0xCodExpert/MotorJig/README.md

# MotorJig
- 모터 및 ST MCU 제어 테스트를 위한 프로젝트 시작
- 모 든 프로젝트는 github 관리를 원칙적으로 한다.
- EziStep  하나를 짜봄으로써 통신에 대해 이해를 넓힌다.

# V0.0 (210315)
- PC to MCU EziStep Protocol 통신 
- PC와 다른 라인으로 MCU to Driver 통신 라인 구현
- 1차 동작 가능 파일 구현
