0xCodExpert/MotorJig/PL/MOTOR JIG_V0.3_201222.xlsx

Sheet: 표지
전자부 Part List
 |  |  | ART_Motor Jig
 |  |  |  |  |  | 2020-12-22 (V0.3)
 | 담당 부서 |  |  |  |  |  | 합의 부서
 | 구분 | 이름 |  | 서명 | 일자 |  | 구분 | 이름 | 서명 | 일자
 | 담당 | 박 성 환 |  |  | 2020-12-22 |  | 담당
 | 검토 | 강 유 정 |  |  | 2020-12-22 |  | 검토
 | 승인 | 윤 경 훈 |  |  | 2020-12-22 |  | 승인
RQP-701-6r2
전자부 Part List Vieworks co.,Ltd.

Sheet: HISTORY
Version History
Version | Date | 변경 부분 | ASS'Y Code | 변경 내용 | 변경 전 | 변경 후 | 참조 문서 | 비고
V0.0 | 2020-12-07 | 최초작성
V0.1 | 2020-12-18 | 정식PL 버전
V0.2 | 2020-12-21 | SMT 과정 오류 발견 수정
V0.3 | 2020-12-22 | SMT 과정 오류 발견 수정

Sheet: ART_MotorJig
MODEL : VISQUE InVivo ART , BOARD NAME : MOTOR_JIG , 보드명 Main PCB Ass'y Code : 1631-3007-D01 .
No. | Part Number | Description | Specification | Manufacturer | Q'ty | Reference | 비고 | 회사 | 개별
1 | 1631-3307-D01 | 140mm x 100mm, FR-4, 2layer, 1.6T, 금도금, 무광 | ART MOTOR JIG PCB | EOS | 1
2 | 9060-0039-10AG | IND-BEAD,120Ω,SMD,1608 | ACMS160808A121 2A | Maxecho | 2 | B1,B2 |  | o
3 |  | CON-HEADER,VERTICAL,2.54,DIP,5P | HEADER2.54MM-5P | GIN LING | 1 | CON1 |  |  | o
4 |  | CON-HEADER,VERTICAL,2.54,DIP,4P | HEADER2.54MM-4P | GIN LING | 1 | CON2 |  |  | o
5 |  | CON-HEADER,RA,5.08,DIP,3P,300V/12A | TB39R(3P) | DINKLE | 4 | CON3,CON5,CON6,CON7 |  |  | o
6 | 9070-0357-01A | CON-USB A type,RECEPTACLE,R/A | 67643-3911 | Molex | 1 | CON4 |  | o
7 |  | CON-HEADER,RA,3.81,DIP,16P | ECH381R(16P) | DINKLE | 1 | CON8 |  |  | o
8 |  | IC-Voltage Translator,8bit,Bidirectional | SN74GTL2003 | Ti | 2 | CON9,CON11 |  |  | o
9 |  | CON-HEADER,RA,3.81,DIP,10P | ECH381R(10P) | DINKLE | 1 | CON12 |  |  | o
10 |  | CON-HEADERBOX,VERTICAL,2.54,DIP,20X2P | HEADER-20X2(2.54MM)_BOX | GIN LING | 1 | CON14 |  |  | o
11 | 9070-0201-00AG | CON-HEADER,VERTICAL,2.5,DIP,2P | 5267-02A | Molex | 2 | CON15,CON16 |  |  | o
12 |  | CON-DC JACK,30V/0.5A,E-type | DC-005 | BSUN | 1 | CON17 |  |  | o
13 |  | CON-HEADER,RA,5.08,DIP,2P,300V/12A | TB39R(2P) | DINKLE | 3 | CON10,CON13,CON18 |  |  | o
14 | 9030-0201-01A | CAP-MLCC,10nF,50V,1608,X7R,±10%,ESD25kV | C0603C103K5REC | KEMET | 1 | C1 |  | o
15 | 9030-0178-01A | CAP-MLCC,22uF,6.3V,2012,X5R,±15% | GRM21BR60J226ME39L | Murata | 1 | C2 |  | o
16 | 9030-0180-11A | CAP-MLCC,10uF,50V,3225,Y5V,-20/+80% | GRM32DF51H106ZA01L | Murata | 5 | C3,C29,C32,C34,C36 |  | o
17 | 9030-0109-00AG | CAP-MLCC,0.1uF,50V,1608,X7R,±10% | CL10B104KB8NNNC | Samsung | 19 | C4,C6,C9,C10,C12, C15,C17,C18,C20,C25 C22,C23,C27,C30,C31, C33,C35,C37,C38 |  | o
18 | 9030-0131-00AG | CAP-MLCC,10uF,50V,3216,X5R,±10% | CL31A106KBHNNNE | Samsung | 1 | C5 |  | o
19 | 9030-0108-00AG | CAP-MLCC,8pF,50V,1608,COG,±0.5pF | CL10C080DBNC | Samsung | 2 | C7,C8 |  | o
20 | 9030-0159-01A | CAP-MLCC,18pF,50V,1608,C0G,±5% | CL10C180JB8NNNC | Samsung | 2 | C11,C14 |  | o
21 | 9030-0119-00AG | CAP-MLCC,2.2uF,25V,1608,X5R,±10% | CL10A225KA5LNN | Samsung | 2 | C13,C19 |  | o
22 | 9030-0264-01A | CAP-MLCC,10uF,25V,1608,X5R,±20% | CL10A106MA8NRNC | Samsung | 3 | C21,C24,C16 |  | o
23 | 9030-0101-00AG | CAP-MLCC,2200pF,50V,1608,X7R,±10% | CL10B222KBNC | Samsung | 1 | C26 |  | o
24 | 9030-0129-00AG | CAP-MLCC,1uF,50V,1608,X5R,±10% | CL10A105KB8NNN | Samsung | 1 | C28 |  | o
25 | 9040-0084-01A | DIO-TVS DIODES,36V,BIDIRECTIONAL,SOD-323 | PSD36C | Protek | 2 | D1,D6 |  |  | o
26 | 9040-0092-00A | DIO-SCHOTTKY,8A,40V,DO214AB | SK84L | Micro | 1 | D2 |  |  | o
27 |  | DIO-ZENER,5.1V,3W,SMD | 1SMB5918BT3G | ON SEMICONDUCTOR | 1 | D3 |  |  | o
28 | 9040-0087-01A | DIO-SCHOTTKY,8A,100V,DO214AB | SK810L | Micro | 2 | D4,D5 |  |  | o
29 |  | DIO-SCHOTTKY,1.5A,24V,SOD-323 | SD103AWS | Guangdong Hottech | 1 | D8 |  |  | o
30 |  | CAP-ELEC,KMG,100uF,35V,CAPE(6.3)P2.5 | KMG/100uF/35V | SamYoung Electronics | 5 | EC1,EC2,EC3,EC6,EC7 |  |  | o
31 | 9030-0181-01A | CAP-MLCC,47uF,16V,3216,X5R,±20% | NC | TDK | 1 | EC4 |  |  | o
32 | 9030-0181-01A | CAP-MLCC,47uF,16V,3216,X5R,±20% | C3216X5R1C476M | TDK | 2 | EC5,EC8 |  | o
33 | 9040-0058-00AG | DIO-TVS DIODES,3V,BIDIRECTIONAL,SOD-323 | GBLC03 | Protek | 5 | IZ1,IZ2,IZ3,IZ4,IZ5 |  |  | o
34 |  | DIO-LED,SMD,1608 | LED-RED | HSUKWANG | 1 | LED1 |  |  | o
35 |  | DIO-LED,3MM,2COLOR | BL-BST201 | Bright Power Semiconductor | 1 | LED2
36 | 9060-0026-00AG | IND-COIL,47uH,2.4A,SMD CORE,±20%,10.1X10.1X4.5 | SHP1045P-F470A | Tokyo-Coil | 1 | L1 |  |  | o
37 |  | CON-RJ45,RA,5e,Modular Jack,8P | 440500001 | Molex | 2 | P1,P2
38 | 9010-0309-00AG | IC-Single P-Channel Mosfet,SO-8 | FDS6675BZ | Fairchild | 2 | Q2,Q4 |  | o
39 | 9050-0005-00AG | TR-BJT,NPN,100mA,Built-in Resistor,SMT3 | DTC143EKA | Rohm | 2 | Q3,Q5 |  | o
40 | 9020-0049-00AG | RES-SMD1608,3.6KΩ,F,1/10W | MCR03EZPFX3601 | Rohm | 1 | R1 |  | o
41 | 9020-0298-01A | RES-SMD1608,11KΩ,F,1/10W | MCR03EZPFX1102 | Rohm | 1 | R2 |  | o
42 | 9020-0067-00AG | RES-SMD1608,470Ω,F,1/10W | MCR03EZPFX4700 | Rohm | 1 | R3 |  | o
43 | 9020-0009-00AG | RES-SMD1608,10KΩ,F,1/10W | MCR03EZPFX1002 | Rohm | 2 | R4,R6 |  | o
44 | 9020-0007-00AG | RES-SMD1608,100Ω,F,1/10W | MCR03EZPFX1000 | Rohm | 1 | R7 |  | o
45 | 9020-0026-00AG | RES-SMD1608,1MΩ,F,1/10W | MCR03EZPFX1004 | Rohm | 1 | R8 |  | o
46 | 9020-0114-00AG | RES-SMD1608,120Ω,F,1/10W | MCR03EZPFX1200 | Rohm | 3 | R9,R11,R12 |  | o
47 | 9020-0064-00AG | RES-SMD1608,4.7KΩ,F,1/10W | MCR03EZPFX4701 | Rohm | 2 | R10,R13 |  | o
48 | 9020-0053-00AG | RES-SMD1608,330Ω,F,1/10W | MCR03EZPFX3300 | Rohm | 2 | R14,R15 |  | o
49 | 9020-0026-00AG | RES-SMD1608,1MΩ,F,1/10W | MCR03EZPFX1004 | Rohm | 1 | R16 |  | o
50 |  |  | NC |  | 1 | R17 |  | o
51 | 9020-0064-00AG | RES-SMD1608,4.7KΩ,F,1/10W | MCR03EZPFX4701 | Rohm | 3 | R18,R60,R61 |  | o
52 | 9020-0023-00AG | RES-SMD1608,1KΩ,F,1/10W | MCR03EZPFX1001 | Rohm | 2 | R19,R21 |  | o
53 |  |  | NC |  | 1 | R20 |  | o
54 | 9020-0188-00AG | RES-SMD1608,200KΩ,F,1/10W | MCR03EZPFX2003 | Rohm | 2 | R22,R41 |  | o
55 | 9020-0498-01A | RES-SMD1608,499Ω,F,1/10W | RC1608F4990CS | Samsung | 16 | R23,R24,R25,R35,R36, R37,R38,R39,R51,R52, R53,R54,R55,R56,R57,R58 |  | o
56 | 9020-0052-00AG | RES-SMD1608,300Ω,F,1/10W | MCR03EZPFX3000 | Rohm | 16 | R26,R27,R28,R29,R30, R31,R33,R34,R42,R43, R44,R45,R46,R47,R49, R50 |  | o
57 | 9020-0009-00AG | RES-SMD1608,10KΩ,F,1/10W | MCR03EZPFX1002 | Rohm | 6 | R40,R59,R66,R67,R68, R69 |  | o
58 | 9020-0189-00AG | RES-SMD1608,20Ω,F,1/10W | MCR03EZPFX20R0 | Rohm | 2 | R62,R63 |  | o
59 | 9020-0289-01A | RES-SMD2012,0Ω,J,1/8W | NC | Rohm | 1 | R64 |  | o
60 | 9020-0289-01A | RES-SMD2012,0Ω,J,1/8W | MCR10EZPJ000 | Rohm | 1 | R65 |  | o
61 |  | SW-TACT,12V,VERTICAL,SMD | TS-1187SMD | 씨티전자 | 1 | SW1 |  |  | o
62 |  | IC-Regulator,Switching,Step-Down,45V,3A | LM2596S-ADJ | UMW | 1 | U1 |  |  | o
63 | 9010-0745-01A | IC-Regulator, LDO, 3.3V, 0.8A, SOT223 | LM1117IMPX-3.3 | Ti | 1 | U2 |  |  | o
64 |  | IC-MCU,M7,Flash-128KB, RAM-1MB,82P | STM32H750VBT6 | ST | 1 | U3
65 | 9010-1092-01A | IC-RS485/RS422 Transceiver,8-SOIC | SP3485EN | MaxLinear | 1 | U4 |  |  | o
66 | 9010-0746-01A | IC-USB to UART, 28-SSOP | FT232RL | FTDI | 1 | U5
67 | 9010-0753-01A | IC-ESD PROTECTION,SON6 | TPD4S012DRYR | Ti | 1 | U6 |  | o
68 | 9010-0711-01A | IC-RS485/RS422 Transceiver,8-SOIC | MAX485CSA | Maxim | 1 | U7 |  |  | o
69 |  | OSC-CRYSTAL,32.7680kHz,7PF,SMD | CM315D32768DZYT-7pF | Citizen | 1 | Y1 |  |  | o
70 | 9080-0035-01A | OSC-CRYSTAL,24MHz,SMD,3.2x2.5mm,18pF,±30ppm | CE300X24003TKO | Exa | 1 | Y2 |  | o
 |  |  |  |  | 164
