0xCodExpert/MotorJig/PL/통합 문서1.xlsx

Sheet: ART_MotorJig
Item | Quantity | Reference | Part | PCB Footprint
1 | 2 | B1,B2 | ACMS160808A121 | L1608
2 | 1 | CON1 | HEADER2.54MM-5P | HEADER2.54MM-5P
3 | 1 | CON2 | HEADER2.54MM-4P | HEADER2.54MM-4P
4 | 4 | CON3,CON5,CON6,CON7 | TB39R(3P) | TB39R(3P)
5 | 1 | CON4 | 67643-3911 | USB_A/67643-3911
6 | 1 | CON8 | ECH381R(16P) | ECH381R(16P)
7 | 2 | CON9,CON11 | SN74GTL2003 | SN74GTL2003
8 | 1 | CON12 | ECH381R(8P) | ECH381R(8P)
9 | 1 | CON14 | HEADER-20X2(2.54MM)_BOX | HEADER-20X2(2.54MM)_BOX
10 | 2 | CON15,CON16 | 5267-02A | 5267-02A
11 | 1 | CON17 | DC-005 | EPX3333K
12 | 3 | CON10,CON13,CON18 | TB39R(2P) | TB39R(2P)
13 | 1 | C1 | 10nF/50V | C1608
14 | 1 | C2 | 22uF/6.3V/2012 | C2012
15 | 5 | C3,C29,C32,C34,C36 | 10uF/50V/3225 | C3225
16 | 19 | C4,C6,C9,C10,C12, C15,C17,C18,C20,C25 C22,C23,C27,C30,C31, C33,C35,C37,C38 | 0.1uF/50V | C1608
17 | 1 | C5 | 10uF/16V/3216 | C3216
18 | 2 | C7,C8 | 8pF | C1608
19 | 2 | C11,C14 | 18pF | C1608
20 | 2 | C13,C19 | 2.2uF | C1608
21 | 3 | C21,C24,C16 | 10uF/10V | C1608
22 | 1 | C26 | 2200pF | C1608
23 | 1 | C28 | 1uF | C1608
24 | 2 | D1,D6 | PSD36C | PSD36C
25 | 1 | D2 | SK84L | SK84L
26 | 1 | D3 | 1SMB5918BT3G | CASE403A
27 | 2 | D4,D5 | SK810L | SK810L
28 | 1 | D8 | SD103AWS | SD103AWS
29 | 5 | EC1,EC2,EC3,EC6,EC7 | 100uF/35V | KMG,100uF/35V
30 | 1 | EC4 | NC | EC-4.8X12-330F/16V
31 | 2 | EC5,EC8 | 100uF/6.3V | C3216
32 | 5 | IZ1,IZ2,IZ3,IZ4,IZ5 | GBLC03 | SOD-323
33 | 1 | LED1 | LED-RED | LED-1608
34 | 1 | LED2 | BL-BST201 | LED(2COL_3P)
35 | 1 | L1 | SHP1045P-F470A | SHP1045P-F470A
36 | 2 | P1,P2 | 440500001 | 440500001
37 | 2 | Q2,Q4 | FDS6675BZ | SO8(P1.27-W7.2)
38 | 2 | Q3,Q5 | DTC143EKA | SOT23-3P
39 | 1 | R1 | 3.6K | R1608
40 | 1 | R2 | 11K | R1608
41 | 1 | R3 | 470R | R1608
42 | 2 | R4,R6 | 10K | R1608
43 | 1 | R7 | 100R | R1608
44 | 1 | R8 | 1M | R1608
45 | 3 | R9,R11,R12 | 120R | R1608
46 | 2 | R10,R13 | 4.7K | R1608
47 | 2 | R14,R15 | 330 | R1608
48 | 1 | R16 | 1M | R1608
49 | 1 | R17 | NC | R1608
50 | 3 | R18,R60,R61 | 4.7K | R1608
51 | 2 | R19,R21 | 1K | R1608
52 | 1 | R20 | NC | R1608
53 | 2 | R22,R41 | 200K | R1608
54 | 16 | R23,R24,R25,R35,R36, R37,R38,R39,R51,R52, R53,R54,R55,R56,R57,R58 | 499 | R1608
55 | 18 | R26,R27,R28,R29,R30, R31,R32,R33,R34,R42, R43,R44,R45,R46,R47, R48,R49,R50 | 300 | R1608
56 | 2 | R40,R59 | 10K | R1608
57 | 2 | R62,R63 | 20 | R1608
58 | 1 | R64 | NC | R2012
59 | 1 | R65 | 0/2012 | R2012
60 | 1 | SW1 | TS-1187SMD | TS-1187SMD
61 | 1 | U1 | LM2596S-ADJ | TO263
62 | 1 | U2 | LM1117IMPX-3.3 | SOT223
63 | 1 | U3 | STM32H750VBT6 | LQFP100P_STM32_0.5_16X16_H1.6
64 | 1 | U4 | SP3485EN | SP485EN-SOIC8-1.27X5X6.2X1.8T
65 | 1 | U5 | FT232RL | FT232RL/SSOP28
66 | 1 | U6 | TPD4S012 | TPD4S012
67 | 1 | U7 | MAX485CSA | SO8(P1.27-W7.2)
68 | 1 | Y1 | CM315D32768DZYT-7pF | XTAL-CM315
69 | 1 | Y2 | SX-1/25MHz | SX-1/25MHz
 | 161

Sheet: Stage_Sub
Item | Quantity | Reference | Part | PCB Footprint
1 | 1 | SB45 | ACMS201209A121 | L2012
2 | 1 | SCON3 | 5267-06A | 5267-6P(P2.5)OK
3 | 1 | SCON8 | ECH381R(16P) | ECH381R(16P)
4 | 1 | SCON9 | SN74GTL2003 | SN74GTL2003
5 | 2 | SCON10,SCON48 | TB39R(2P) | TB39R(2P)
6 | 2 | SCON45,SCON46 | 5267-02A | 5267-2P(P2.5)OK
7 | 1 | SCON47 | 53047_1510 | 53047-1510(15P-1.25)
8 | 3 | SC1,SC2,SC3 | 22uF/35V | C3216
9 | 1 | SC3 | 10uF | C2012
10 | 2 | SC4,SC5 | 10uF/50V | C3216
11 | 3 | SC5,SC223,SC224 | 0.1uF | C1608
12 | 1 | SC6 | 10u/6.3V | C1608
13 | 4 | SC29,SC32,SC225,SC226 | 10u/50V | C2012
14 | 2 | SC30,SC31 | 0.1uF | C1608
15 | 1 | SD1 | STPS40L45CG | D2PAK/STPS40L45CG
17 | 2 | SQ2,SQ5 | FDS6675BZ | SO8(P1.27-W7.2)
18 | 2 | SQ3,SQ6 | DTC143EKA | SOT23-3P
19 | 1 | SR3 | 10 | R1608
20 | 1 | SR22 | 200K | R1608
21 | 6 | SR23,SR35,SR36,SR37,SR38, SR39 | 499 | R1608
22 | 6 | SR28,SR29,SR30,SR31,SR33, SR34 | 300 | R1608
23 | 2 | SR40,SR326 | 10K | R1608
24 | 2 | SR324,SR325 | 4.7K | R1608
25 | 1 | SR327 | 0/NC | R1608
26 | 1 | SR328 | 0/2012/NC | R2012
27 | 2 | SR329,SR330 | 20 | R1608
28 | 1 | SR331 | 0/2012 | R2012
29 | 1 | SU3 | LM1117IMPX-3.3 | SOT-223
30 | 2 | SZ1,SZ2 | PSD36C | SOD-323
 | 56
