0xCodExpert/MotorJig/Circuit/ART_MOTORJIG(201208).pdf

5

4

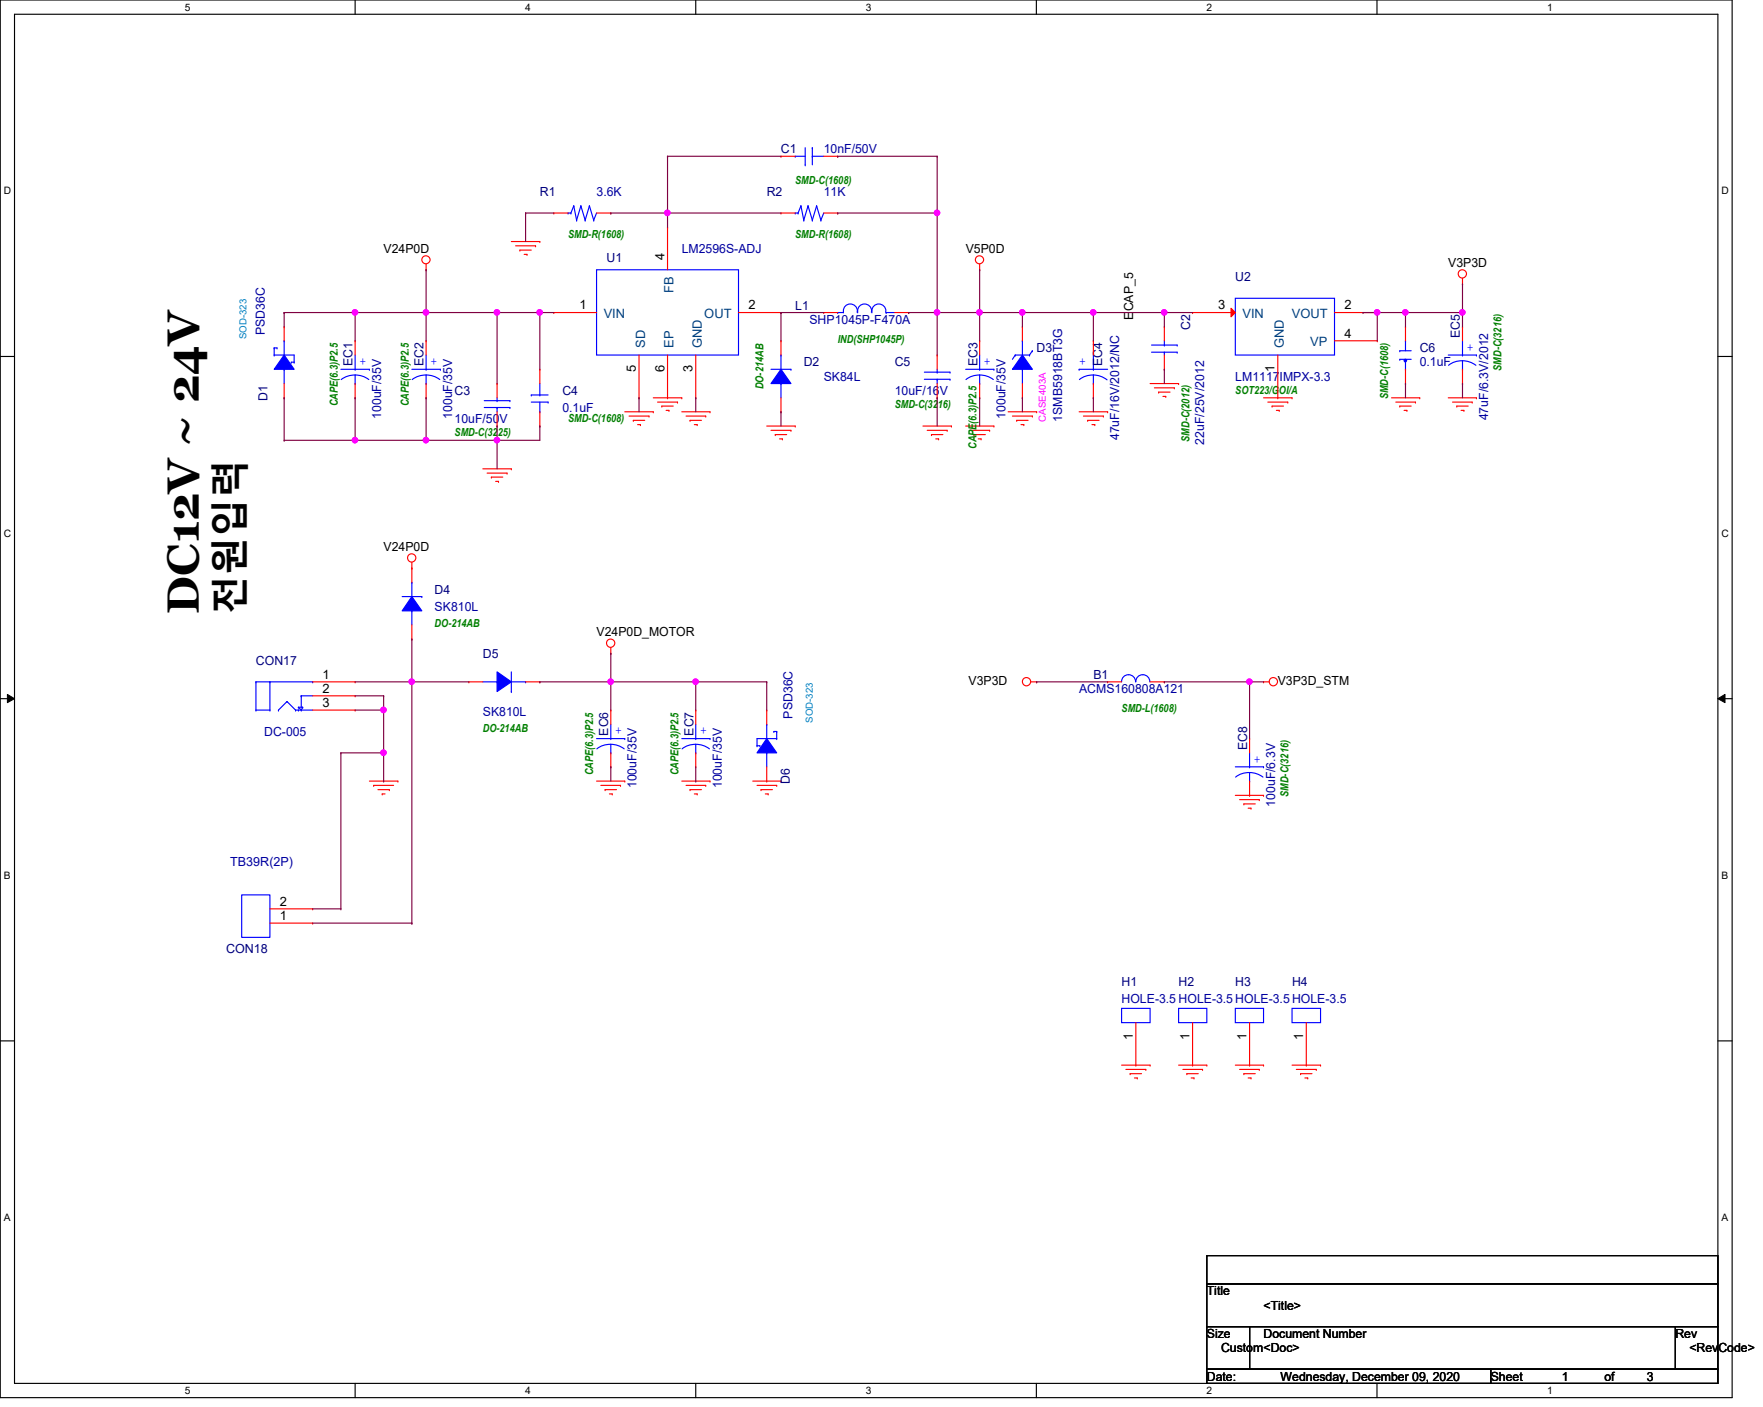
[picture p5: page 1]

# MCU RESET

# RTC XTAL

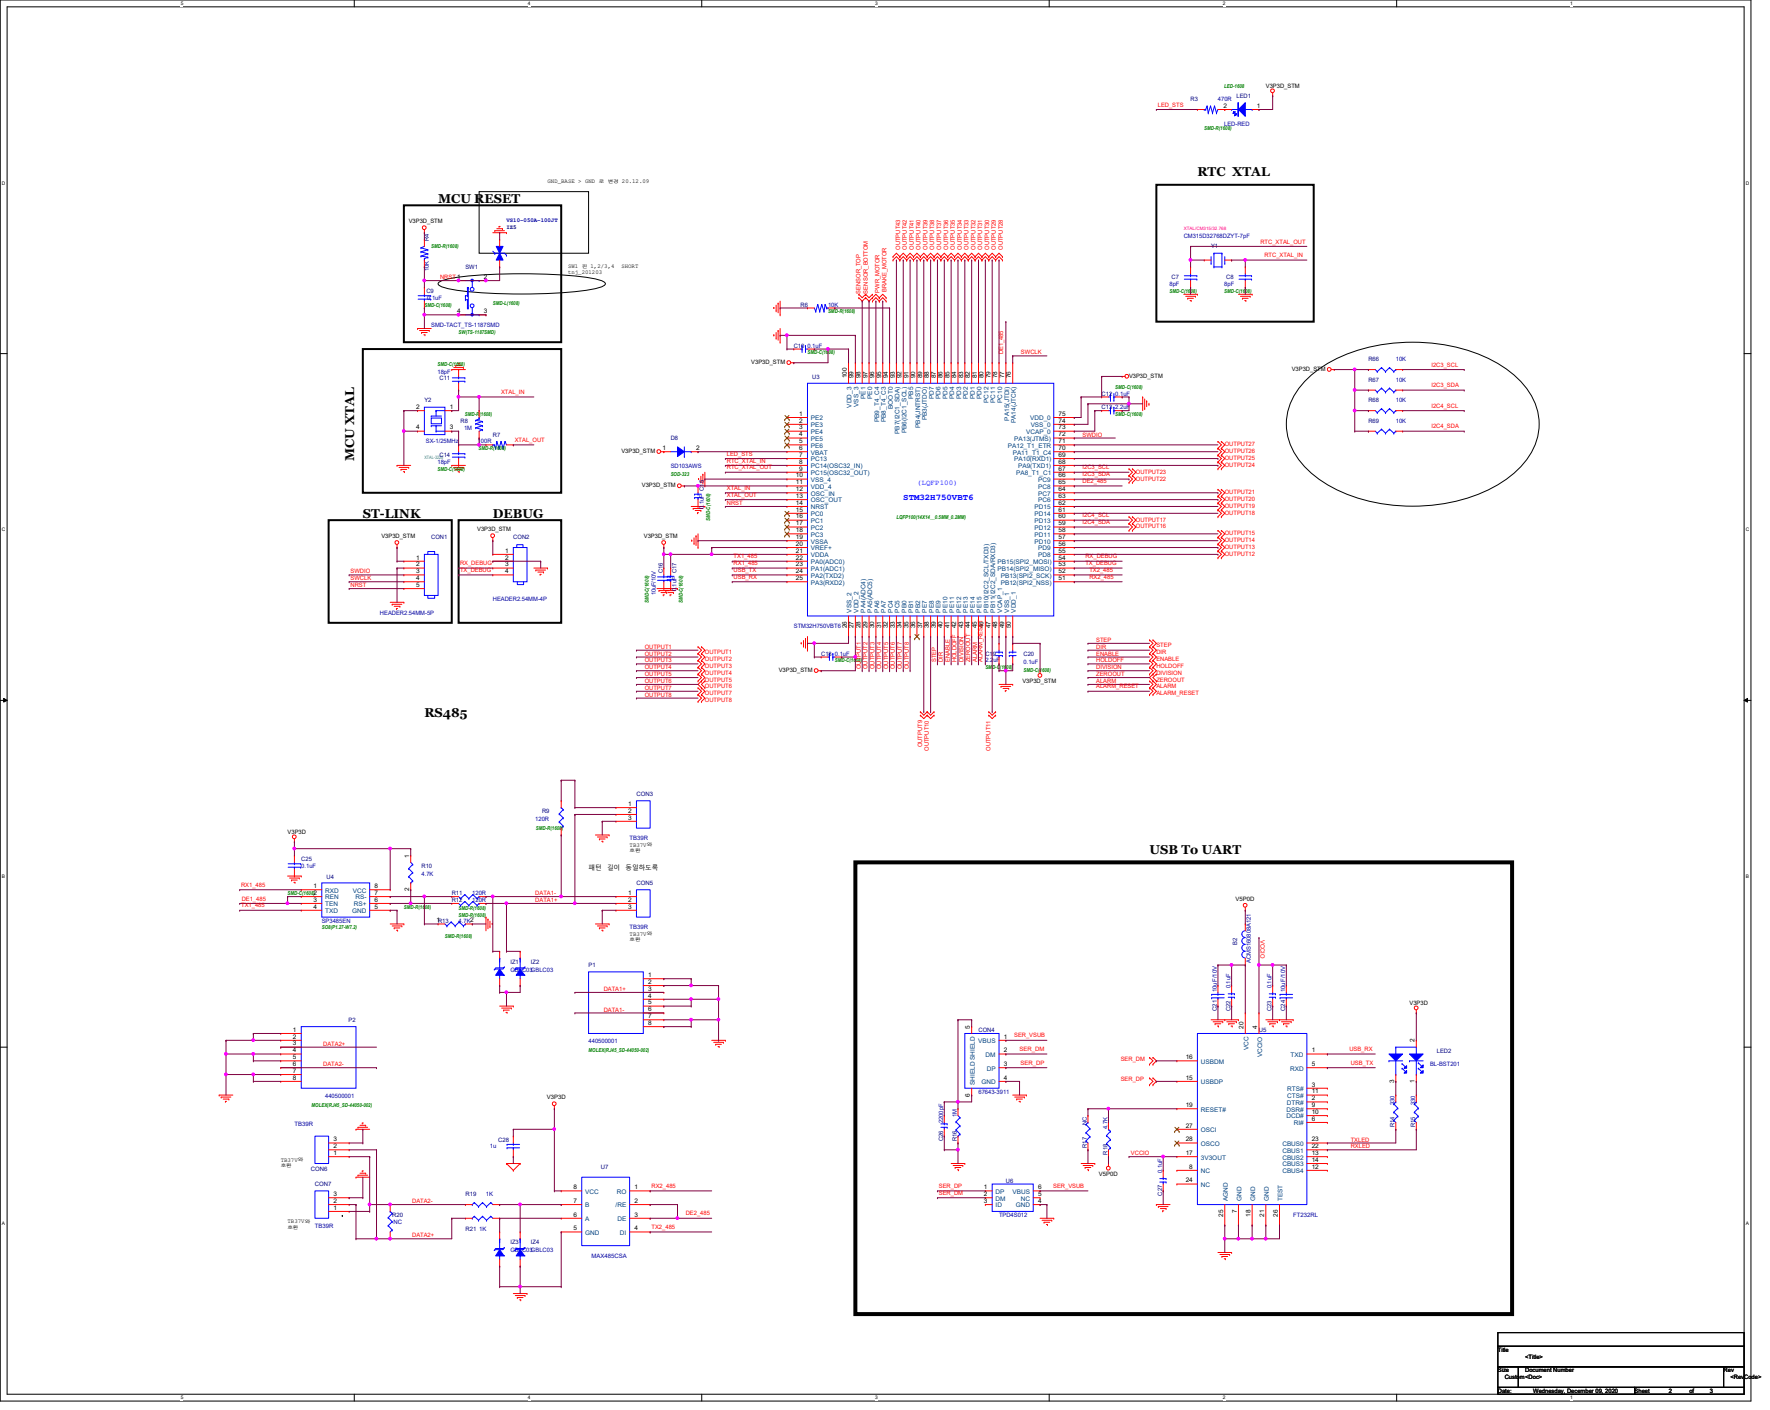
[picture p6: page 2]

D D

## R32/R48 부품 겹쳐서

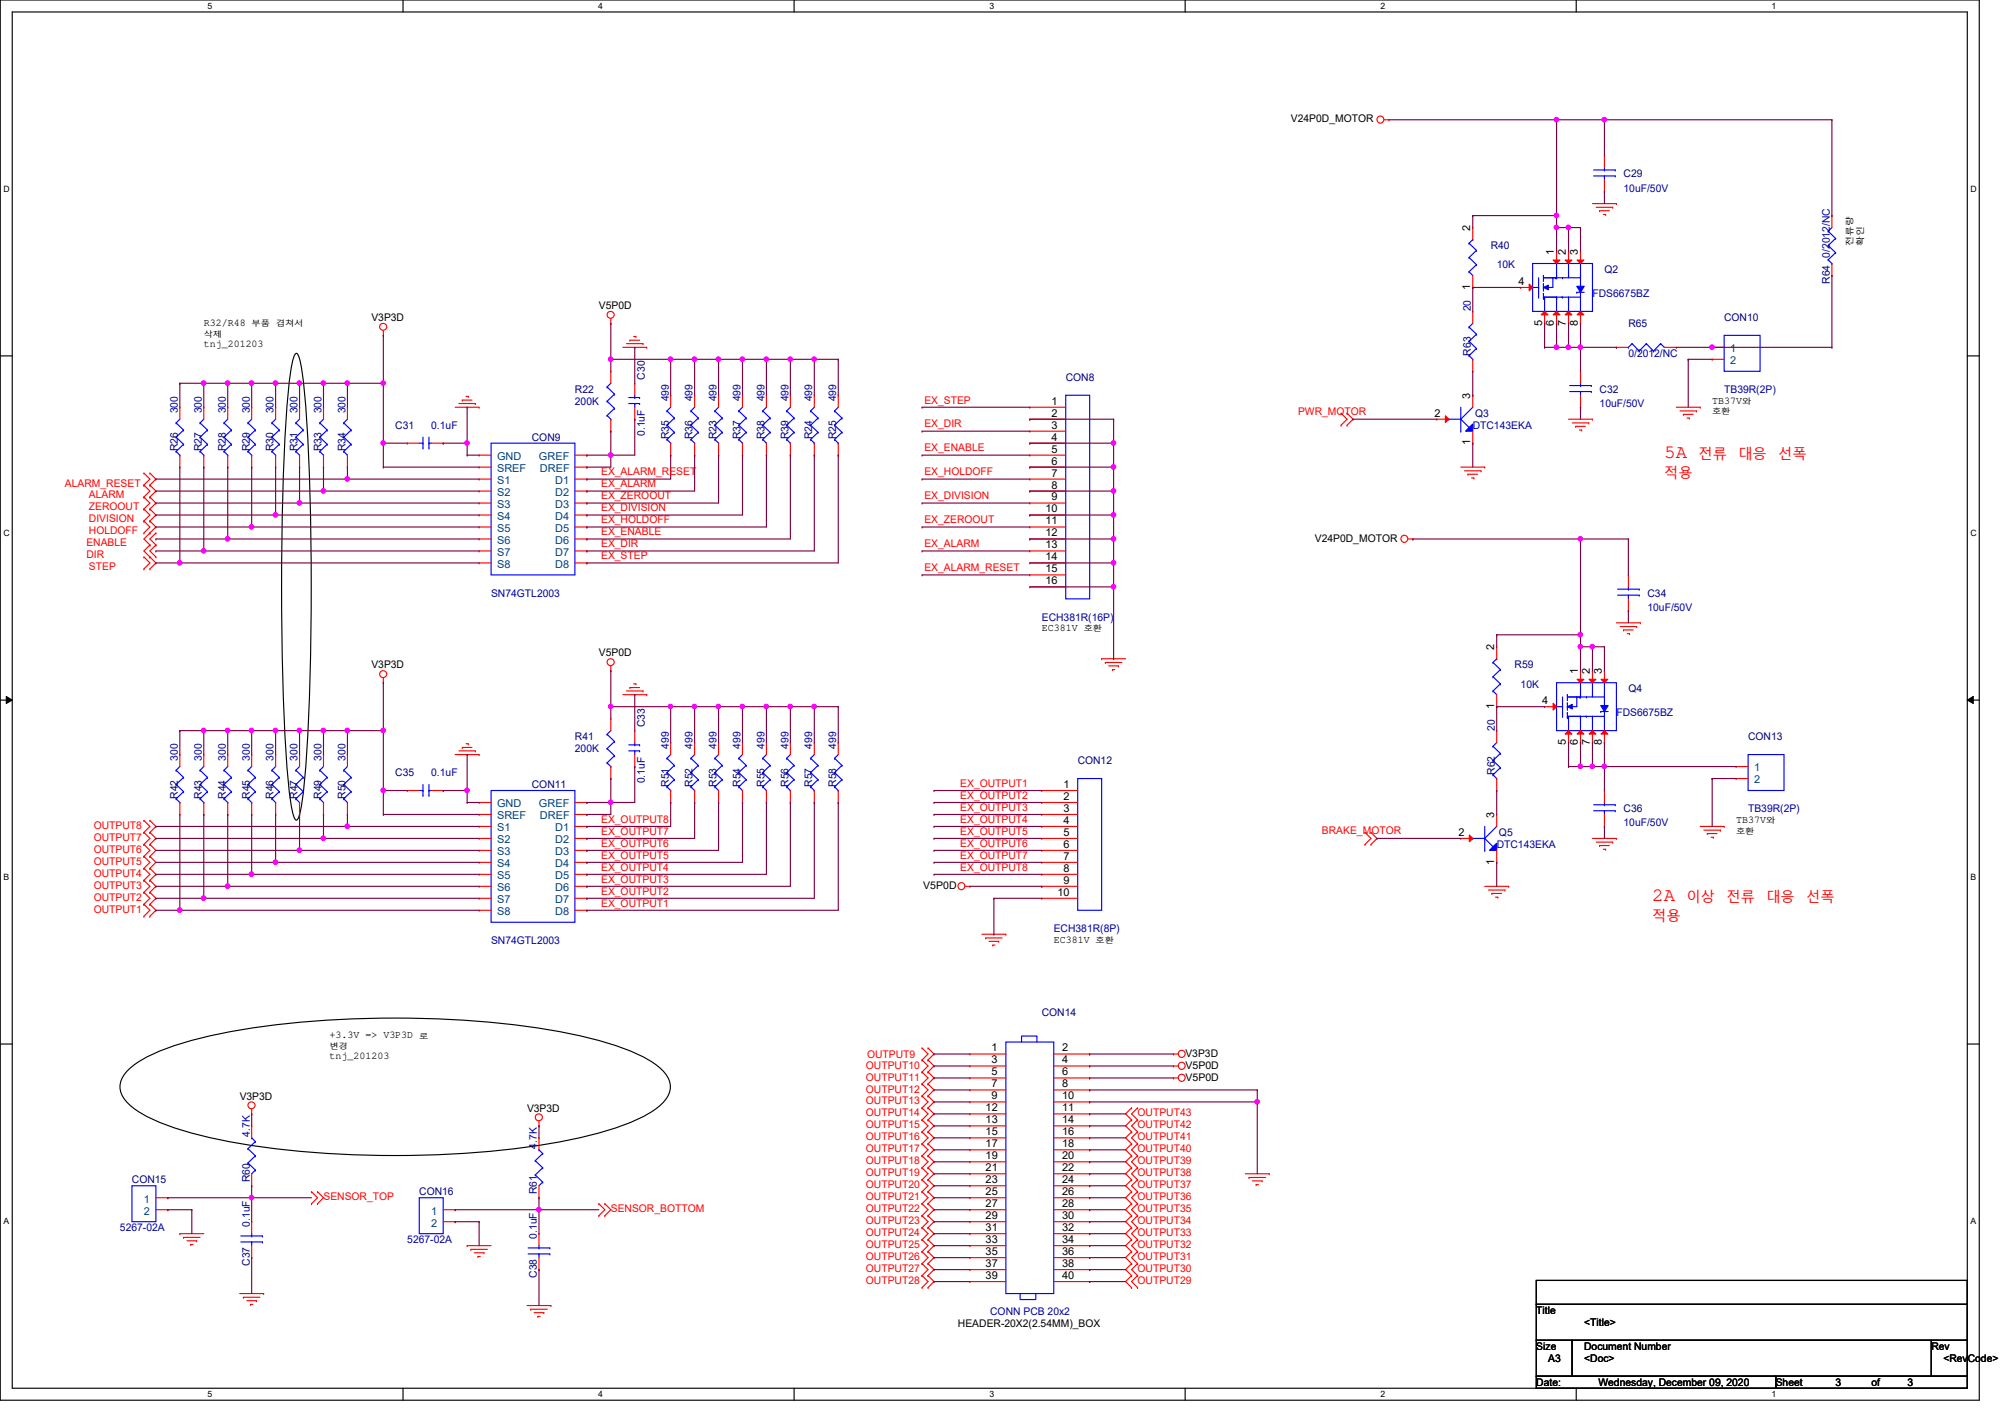
[picture p7: page 3]
