0xCodExpert/MotorJig/(list of files, drawings)

Other design files:
Circuit/MOTORJIG(201208)SCH.DSN
PCB/1631-3307-D01 VISQUE INVIVO ART_MOTOR JIG_PCB_201208.pcb
