0xCodExpert/MotorJig/MotorJig_nonOS/Core/Src/main.c

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
/* Includes ------------------------------------------------------------------*/
#include "main.h"

/* USER CODE BEGIN Includes */
#include "common.h"
#include "comm.h"
#include "EziStep.h"
#include "Vl53l1x.h"
#include "tmr.h"
/* USER CODE END Includes */

/* USER CODE BEGIN PD */
#define EZISTEP         TRUE 
#define VL53L1X         FALSE 
#define TEST			FALSE
/* USER CODE END PD */


I2C_HandleTypeDef hi2c4;

TIM_HandleTypeDef htim6;

UART_HandleTypeDef huart4;
UART_HandleTypeDef huart5;
UART_HandleTypeDef huart1;
UART_HandleTypeDef huart2;

void SystemClock_Config(void);
static void MX_GPIO_Init(void);
static void MX_UART4_Init(void);
static void MX_USART2_UART_Init(void);
static void MX_I2C4_Init(void);
static void MX_USART1_UART_Init(void);
static void MX_UART5_Init(void);
static void MX_TIM6_Init(void);
/* USER CODE BEGIN PFP */
void LedOnOff(void* pState);
/* USER CODE END PFP */

/* USER CODE BEGIN 0 */
uint8_t Rx4Data;
uint8_t Rx5Data;

void HAL_UART_RxCpltCallback(UART_HandleTypeDef *huart)
{
 if(huart->Instance == UART4) //From PC <---> MCU
	{
		CommPutRxChar(&RingBuf_EziStep, Rx4Data);
		HAL_UART_Receive_IT(&huart4, &Rx4Data, sizeof(Rx4Data));
	}
 if(huart->Instance == UART5) // MCU <---> Driver
	{
		CommPutRxChar(&RingBuf_EziStep2, Rx5Data);
		HAL_UART_Receive_IT(&huart5, &Rx5Data, sizeof(Rx5Data));
	}
}

volatile int IntCount;
#define isInterrupt 1 /* If isInterrupt = 1 then device working in interrupt mode, else device working in polling mode */
void HAL_GPIO_EXTI_Callback(uint16_t GPIO_Pin)
{
  if (GPIO_Pin == GPIO_PIN_14)
  {
    IntCount++;

  }
}

void LedOnOff(void* pState)
{
  LED_STATE state = *(LED_STATE*) pState;
  if (state == LED_ON)
  {
    HAL_GPIO_TogglePin(GPIOC, GPIO_PIN_13);
  }
}
/* USER CODE END 0 */

/**
  * @brief  The application entry point.
  * @retval int
  */
int main(void)
{
  /* USER CODE BEGIN 1 */
	uint8_t data_EziStep;
	uint8_t data_EziStep2;

	//address, func, .....  hard coding for test
	uint8_t buf[] = { 0x01, 0x03, 0x4, 0x00, 0x03, 0x00, 0x04, 0xFF, 0xFF };
	uint8_t buf2[] = { 0xaa, 0xcc, 0x01, 0x01, 0x00, 0x14, 0x00 ,0x00, 0xaa, 0xee};

	uint16_t crc16_EziStep;

  /* USER CODE END 1 */

  /* MCU Configuration--------------------------------------------------------*/

  /* Reset of all peripherals, Initializes the Flash interface and the Systick. */
  HAL_Init();

  /* Configure the system clock */
  SystemClock_Config();

  /* Initialize all configured peripherals */
  MX_GPIO_Init();
  MX_UART4_Init();
  MX_USART2_UART_Init();
  MX_I2C4_Init();
  MX_USART1_UART_Init();
  MX_UART5_Init();
  MX_TIM6_Init();
  /* USER CODE BEGIN 2 */
  CommInit(&RingBuf_EziStep);
  CommInit(&RingBuf_EziStep2);

  EziStepInit(&EziStep,  0x01); //0x01 ==> MCU Slave ID default 
  //VL53L1XInit();

  /* timer */
  LED_STATE state = LED_ON;
  TmrInit(TmrTbl);
  TmrSetT(TmrTbl, 0, 1000);
  TmrSetFnct(TmrTbl, 0, LedOnOff, &state);
  // TmrStart(TmrTbl, 0);

  HAL_UART_Receive_IT(&huart4, &Rx4Data, sizeof(Rx4Data));
  HAL_UART_Receive_IT(&huart5, &Rx5Data, sizeof(Rx5Data));

  HAL_TIM_Base_Start_IT(&htim6);
  /* USER CODE END 2 */

  /* Infinite loop */
  /* USER CODE BEGIN WHILE */
  while (1)
  {
#if VL53L1X == TRUE
	  //VL53L1XProcessData();
#endif

#if EZISTEP == TRUE
	  if ( CommIsEmpty(&RingBuf_EziStep) == FALSE )
	  {
		  data_EziStep = CommGetRxChar(&RingBuf_EziStep);
		  //HAL_UART_Transmit(&huart4, &data, sizeof(data), 0xFFFFFFFF);
		  EziStepProcessData(&EziStep, data_EziStep);
	  }

	  if ( CommIsEmpty(&RingBuf_EziStep2) == FALSE )
	  {
		  data_EziStep2 = CommGetRxChar(&RingBuf_EziStep2);
		  //HAL_UART_Transmit(&huart4, &data, sizeof(data), 0xFFFFFFFF);
		  EziStepProcessData(&EziStep, data_EziStep2);
	  }

	  if( EziStep.done == TRUE )
	  {
		  EziStep.done = FALSE;

      switch (EziStep.slaveID)
      {
        case 1: 
          EziStep.slaveID = 2;
          EziStepSendData(&EziStep);
          break;
        case 2: 
          EziStep.slaveID = 1;
          EziStepSendData(&EziStep);
          HAL_GPIO_TogglePin(GPIOC, GPIO_PIN_13);
          break;
      }
		  // crc16_EziStep = EziStepCalCRC16(&buf2[2], 4);
		  // buf2[6]  = (uint8_t)crc16_EziStep;
		  // buf2[7] = (uint8_t)(crc16_EziStep >> 8);
		  // HAL_UART_Transmit(&huart4, buf2, sizeof(buf2), 0xFFFFFFFF);
//		  switch( Modbus.function ){
//		  case 0:
//		  case 1:
//		  case 2:
//		  }
	  }
#endif

#if TEST == TRUE
	  if( HAL_GPIO_ReadPin(GPIOD, GPIO_PIN_7) == GPIO_PIN_RESET){
      HAL_GPIO_yWritePin(GPIOC, GPIO_PIN_13, GPIO_PIN_SET);
	  }
	  else{
		  HAL_GPIO_WritePin(GPIOC, GPIO_PIN_13, GPIO_PIN_RESET);
	  }
#endif

    /* USER CODE END WHILE */

    /* USER CODE BEGIN 3 */
  }
  /* USER CODE END 3 */
}

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
 /**
  * @brief  Period elapsed callback in non blocking mode
  * @note   This function is called  when TIM7 interrupt took place, inside
  * HAL_TIM_IRQHandler(). It makes a direct call to HAL_IncTick() to increment
  * a global variable "uwTick" used as application time base.
  * @param  htim : TIM handle
  * @retval None
  */
void HAL_TIM_PeriodElapsedCallback(TIM_HandleTypeDef *htim)
{
  if (htim->Instance == TIM7) {
    HAL_IncTick();
  }
  /* USER CODE BEGIN Callback 1 */
  if (htim->Instance == TIM6) {
	  TmrTask(TmrTbl);
  }
  /* USER CODE END Callback 1 */
}

/**
  * @brief  This function is executed in case of error occurrence.
  * @retval None
  */
void Error_Handler(void)
{
  /* USER CODE BEGIN Error_Handler_Debug */
  /* User can add his own implementation to report the HAL error return state */
  __disable_irq();
  while (1)
  {
  }
  /* USER CODE END Error_Handler_Debug */
}

#ifdef  USE_FULL_ASSERT
/**
  * @brief  Reports the name of the source file and the source line number
  *         where the assert_param error has occurred.
  * @param  file: pointer to the source file name
  * @param  line: assert_param error line source number
  * @retval None
  */
void assert_failed(uint8_t *file, uint32_t line)
{
  /* USER CODE BEGIN 6 */
  /* User can add his own implementation to report the file name and line number,
     ex: printf("Wrong parameters value: file %s on line %d\r\n", file, line) */
  /* USER CODE END 6 */
}
#endif /* USE_FULL_ASSERT */

/************************ (C) COPYRIGHT STMicroelectronics *****END OF FILE****/
