0xCodExpert/MotorJig/MotorJig_nonOS/MotorJig_nonOS.ioc

Mcu.UserName=STM32H750VBTx
PA0.Signal=UART4_TX
PA1.Signal=UART4_RX
PA2.Signal=USART2_TX
PA3.Signal=USART2_RX
PB12.Signal=UART5_RX
PB13.Signal=UART5_TX
PB14.Signal=USART1_TX
PB15.Signal=USART1_RX
PC13.Signal=GPIO_Output
PC8.Signal=UART5_DE
PD12.Signal=I2C4_SCL
PD13.Signal=I2C4_SDA
PD14.Signal=GPXTI14
PD7.Signal=GPIO_Input
