0xCodExpert/MotorJig/MotorJig_RTOS/Core/Src/func.c

/***********************************************************************************************//**
* \file	  func.c
* \brief
* \author Gone
* <pre>
* Ver   Date       Changes
* ----- ---------- -----------------------------------------------
* 00.01 2020/11/17 file generated
* </pre>
*
***************************************************************************************************/

/***************************************************************************************************
*	Include Files
***************************************************************************************************/
#include "define.h"

/***************************************************************************************************
*	Constant Definitions
***************************************************************************************************/


/***************************************************************************************************
*	Type Definitions
***************************************************************************************************/


/***************************************************************************************************
*	Macros (Inline Functions) Definitions
***************************************************************************************************/


/***************************************************************************************************
*	Variable Definitions
***************************************************************************************************/


/***************************************************************************************************
*	Function Prototypes
***************************************************************************************************/


/***********************************************************************************************//**
* \brief
* \param
* \return
* \note
***************************************************************************************************/
//void led_toggle(void)
//{
//	if(ledTogTimer == 0) {
//		ledTogTimer = 500;
//		HAL_GPIO_TogglePin(GPIOC, GPIO_PIN_13);
//	}
//}

/***********************************************************************************************//**
* \brief
* \param
* \return
* \note
***************************************************************************************************/
void uart1_check(void)
{
//	if(Rx1PkFlag){
////		printf("uart1_check\r\n");
//		Uart_Printf("uart1_check\r\n");
//		Rx1PkFlag=0;
//	}
}

/***********************************************************************************************//**
* \brief
* \param
* \return
* \note
***************************************************************************************************/
void timer_check(void)
{
	if(TimSetTimer == 0) {
		TimSetTimer = 2000;
//		printf("duty = %d, Freq = %d\r\n", cap_duty, cap_freq);
		Uart_Printf("dutyTest = %d, FreqTest = %d\r\n", cap_duty, cap_freq);
	}
}
