0xCodExpert/MotorJig/(commit log)

2021-02-08 First Project
    [1631-3307-D01 VISQUE INVIVO ART_MOTOR JIG_PCB_201208.pcb, 1631-3307-D01_VISQUE INVIVO ART_MOTOR JIG_좌표_201208.xlsx, Part List(수정내역)_수정.xlsx, VISQUE INVIVO ART_MOTORJIG(201208)SCH-1BE.DSN, [D-20-1124] VISQUE InVivo ART_PL_MOTOR JIG_V0.3_201222.xlsx, visque invivo art_motorjig(201208)sch-1be.opj, 통합 문서1.xlsx]
2021-03-19 V0.0 MotorJig with two Serial Port
    [1631-3307-D01_VISQUE INVIVO ART_MOTOR JIG_좌표_201208.xlsx, MOTOR JIG_V0.3_201222.xlsx, MOTOR JIG_좌표_201208.xlsx, MOTORJIG(201208)SCH.DSN, Part List(수정내역)_수정.xlsx, [D-20-1124] VISQUE InVivo ART_PL_MOTOR JIG_V0.3_201222.xlsx, visque invivo art_motorjig(201208)sch-1be.opj]
